gtetil/sap-system/sap-pcb/Sap Schematic.pdf

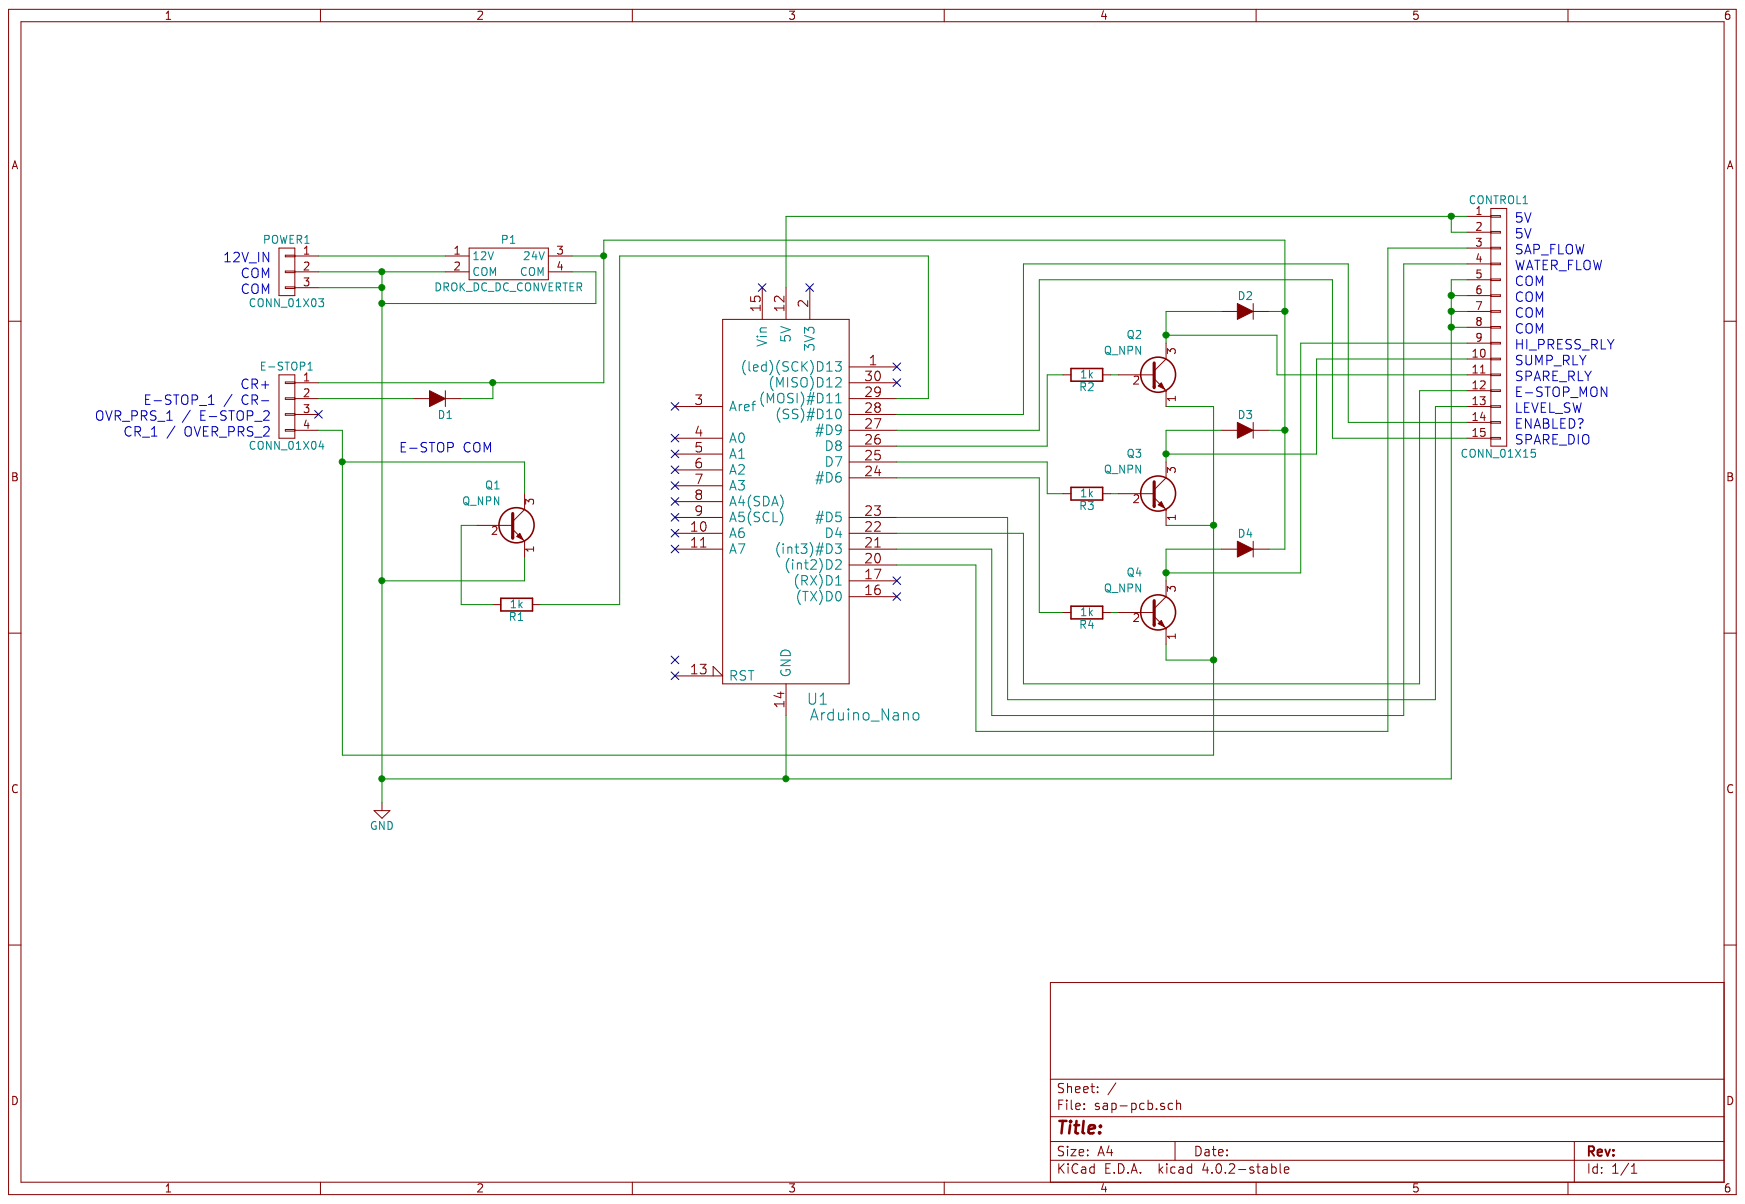
[picture p1: page 1]
