gtetil/sap-system/sap-pcb/sap-pcb.kicad_pcb

## KiCad design sap-pcb/sap-pcb.kicad_pcb (2017-02-03)

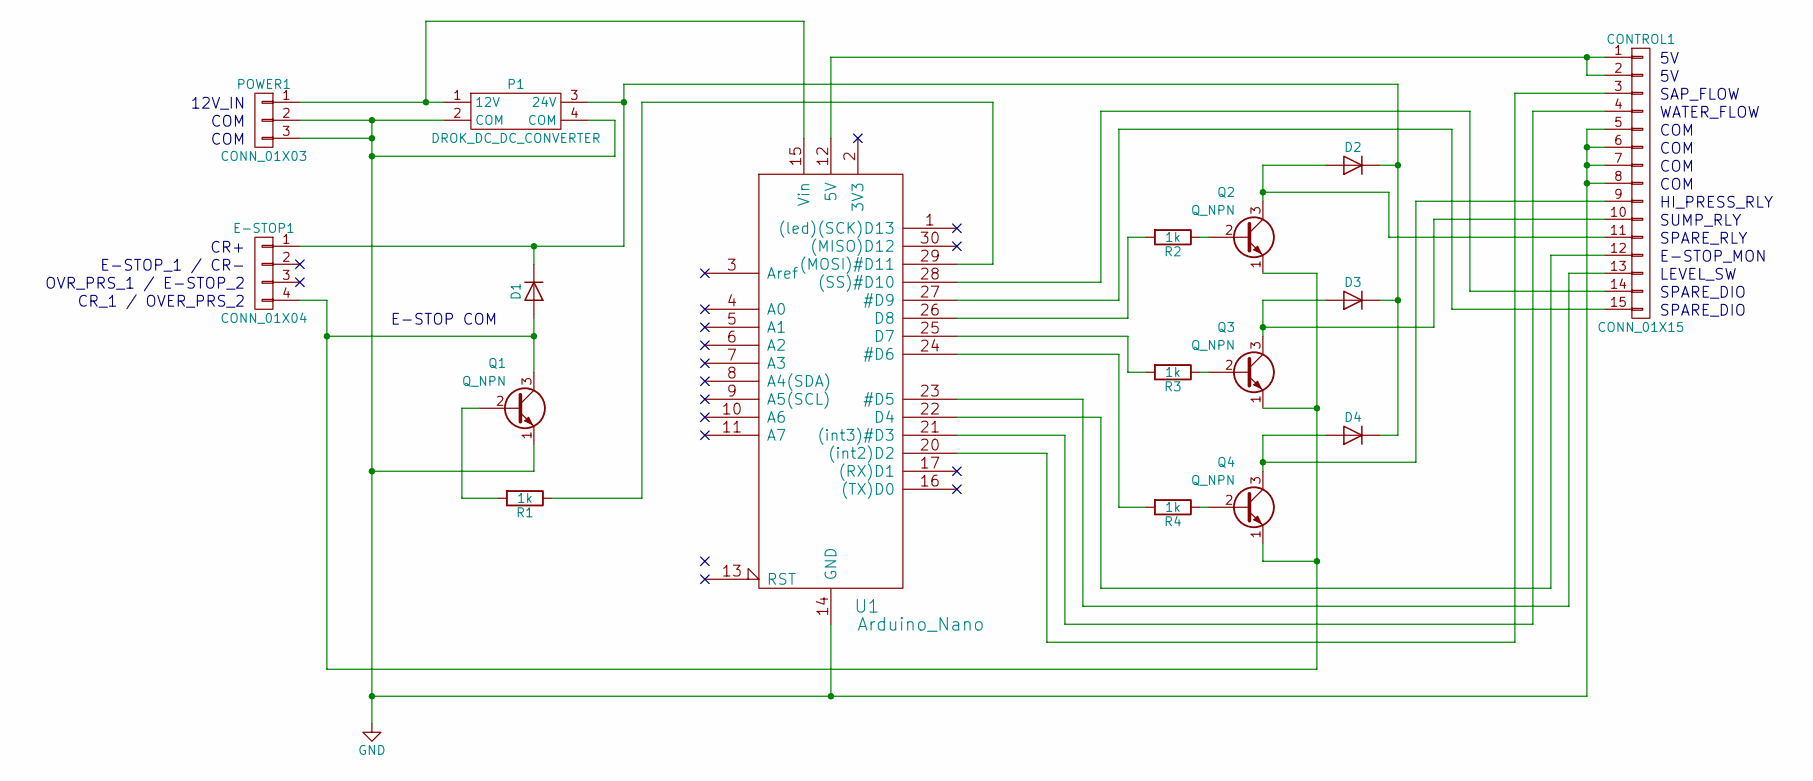
[picture p2: schematic sap-pcb.sch]

Parts:
CONTROL1: CONN_01X15; 15-PIN_CONN
D1, D2, D3, D4: D; D_A-405_P10.16mm_Horizontal
E-STOP1: CONN_01X04; 4-PIN_CONN
P1: DROK_DC_DC_CONVERTER
POWER1: CONN_01X03; 3-PIN_CONN
Q1, Q2, Q3, Q4: Q_NPN; TRANSISTOR
R1, R2, R3, R4: 1k; R_Axial_DIN0207_L6.3mm_D2.5mm_P10.16mm_Horizontal
U1: Arduino_Nano; ARDUINO_NANO

Connections:
GND: CONTROL1.5, CONTROL1.6, CONTROL1.7, CONTROL1.8, P1.2 (COM), P1.4 (COM), POWER1.2, POWER1.3, Q1.1 (E), U1.14 (GND), U1.19 (GND)
unnamed: CONTROL1.1, CONTROL1.2, U1.12 (5V)
unnamed: CONTROL1.3, U1.20 ((int2)D2)
unnamed: CONTROL1.4, U1.21 ((int3)#D3)
unnamed: CONTROL1.9, D4.2 (A), Q4.3 (C)
unnamed: CONTROL1.10, D3.2 (A), Q3.3 (C)
unnamed: CONTROL1.11, D2.2 (A), Q2.3 (C)
unnamed: CONTROL1.12, U1.22 (D4)
unnamed: CONTROL1.13, U1.23 (#D5)
unnamed: CONTROL1.14, U1.28 ((SS)#D10)
unnamed: CONTROL1.15, U1.27 (#D9)
unnamed: D1.1 (K), D2.1 (K), D3.1 (K), D4.1 (K), E-STOP1.1, P1.3 (24V)
unnamed: D1.2 (A), E-STOP1.4, Q1.3 (C), Q2.1 (E), Q3.1 (E), Q4.1 (E)
unnamed: P1.1 (12V), POWER1.1, U1.15 (Vin)
unnamed: Q1.2 (B), R1.2
unnamed: Q2.2 (B), R2.1
unnamed: Q3.2 (B), R3.1
unnamed: Q4.2 (B), R4.1
unnamed: R1.1, U1.29 ((MOSI)#D11)
unnamed: R2.2, U1.26 (D8)
unnamed: R3.2, U1.25 (D7)
unnamed: R4.2, U1.24 (#D6)

Notes on the sheet:
12V_IN
COM
E-STOP_1 / CR-
OVR_PRS_1 / E-STOP_2
CR+
CR_1 / OVER_PRS_2
SAP_FLOW
WATER_FLOW
HI_PRESS_RLY
SUMP_RLY
SPARE_RLY
E-STOP_MON
LEVEL_SW
SPARE_DIO
E-STOP COM

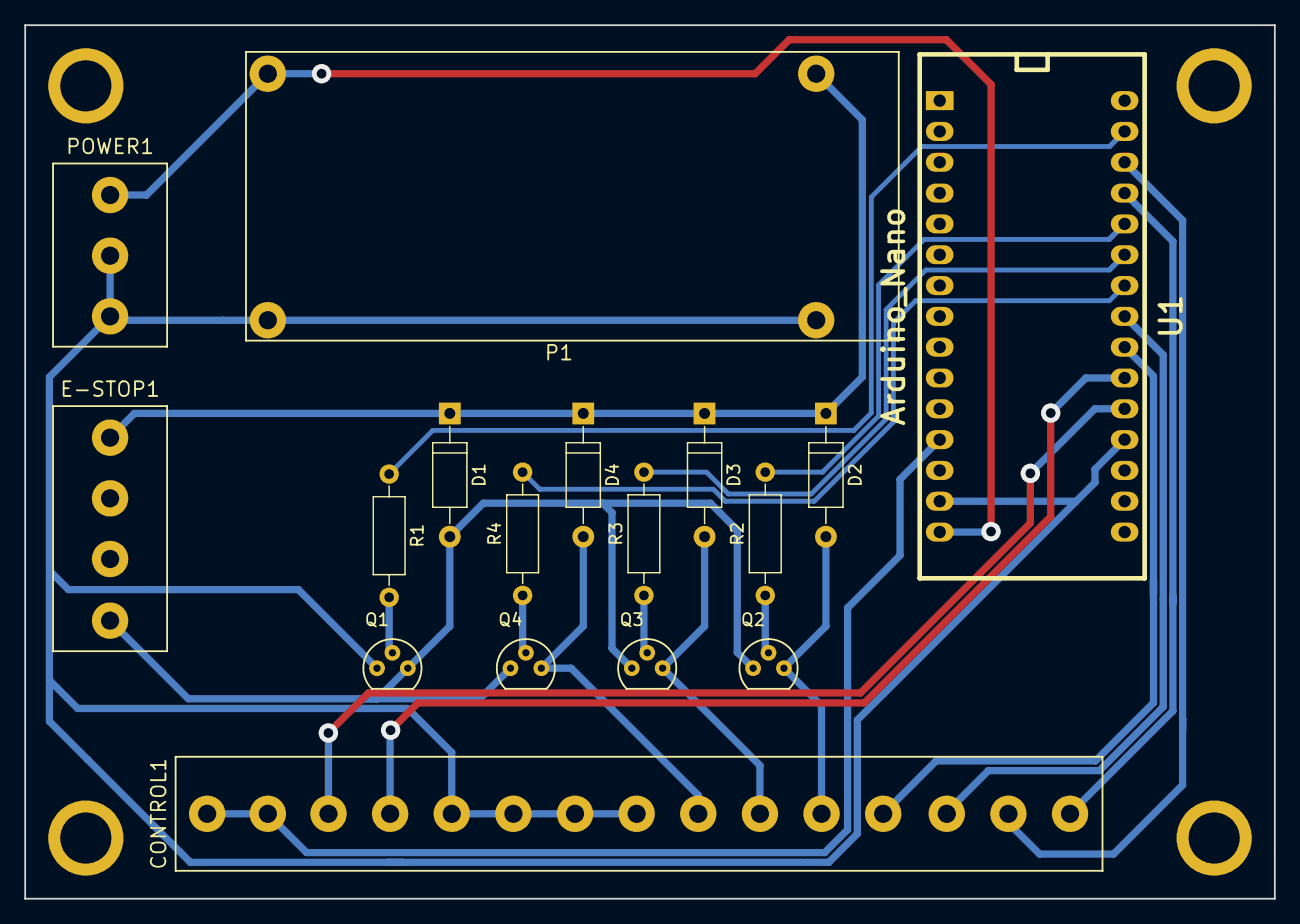
[picture p3: board sap-pcb.kicad_pcb from above]

Board: 2 copper layers, 103.0 x 72.0 mm, 17 parts (0 on the bottom side), 22 nets.
