gtetil/sap-system/sap_arduino/sap_arduino.ino

//flow meter pins (interrupts)
const byte sap_flow_pin = 2;
const byte water_flow_pin = 3;

//digital output pins
int hi_press_rly_pin = 6;
int sump_rly_pin = 7;
int spare_rly_pin = 8;
int enable_pin = 11;

//digital input pins
int estop_mon_pin = 4;
int level_sw_pin = 5;
int enabled_mon_pin = 10;

//digital output states
int hi_press_rly = 0;
int sump_rly = 0;
int spare_rly = 0;

//digital input states
int estop_mon = 0;
int level_sw = 0;
int enabled_mon = 0;

//config
int level_sw_mode = 0;
int min_flow = 3;
int hp_pump_on_delay = 5;

//sap flow variables

double sap_flow;
volatile unsigned long sap_count; //This integer needs to be set as volatile to ensure it updates correctly during the interrupt process.
unsigned long sap_prev_count;

unsigned long sap_delta_count;
double sap_k_factor;
double sap_cnts_per_gal = 3800;
double sap_gallons;

//water flow variables
double water_flow;
volatile unsigned long water_count; //This integer needs to be set as volatile to ensure it updates correctly during the interrupt process.
unsigned long water_prev_count;
unsigned long water_delta_count;
double water_k_factor;
double water_cnts_per_gal = 3800;
double water_gallons;

//total flow
double total_flow;
double total_gallons;
double efficiency;
double efficiency_total;

//auto mode
int run_auto;
int hp_pump_event;
int low_flow_flag;
int low_level_flag;

//delay auto mod
int delay_auto;
int prev_delay_auto;
double delay_hours;
double delay_hours_latched;
double countdown;
unsigned long delay_start_time = millis();
double elapsed_delay;

//misc
String data_string;
int system_status;
unsigned long main_timer = millis();
unsigned long flow_timer = millis();
unsigned long low_flow_timer = millis();
unsigned long hp_timer = millis();
int hp_delay_trigger;

void setup() {
  //serial setup
  Serial.begin(115200);
  
  //setup flow meter interrupts
  pinMode(sap_flow_pin, INPUT_PULLUP);
  attachInterrupt(digitalPinToInterrupt(sap_flow_pin), sapFlow, RISING);
  pinMode(water_flow_pin, INPUT_PULLUP);
  attachInterrupt(digitalPinToInterrupt(water_flow_pin), waterFlow, RISING);  
  
  //setup digital outputs and inputs
  pinMode(hi_press_rly_pin, OUTPUT);   //HI_PRESS_RLY
  pinMode(sump_rly_pin, OUTPUT);   //SUMP_RLY
  pinMode(spare_rly_pin, OUTPUT);   //SPARE_RLY
  pinMode(enable_pin, OUTPUT);   //ENABLE
  pinMode(estop_mon_pin, INPUT_PULLUP);  //E-STOP_MON
  pinMode(level_sw_pin, INPUT_PULLUP);  //LEVEL_SW
  pinMode(enabled_mon_pin, INPUT_PULLUP);  //ENABLED?

}

void loop() {

  if ((millis() - main_timer) >= 100) {
    main_timer = millis();
    digitalInputs();
    sendData();
  }

  if (total_flow > min_flow) {
    low_flow_timer = millis();
  }

  if ((millis() - flow_timer) >= 1000) {  //timed loop for flow calculations
    flow_timer = millis();
    calcSapFlow();
    calcWaterFlow();
    calcTotalFlow();
  }

  checkSerial();
  
  if ((hp_delay_trigger ==1) && (millis() - hp_timer) >= (hp_pump_on_delay * 1000)) {
    hp_delay_trigger = 0;
    digitalOutput("hi_press_rly", 1);
    low_flow_timer = millis();
  }
  
  if (enabled_mon == 0) {  //if estop circuit opens, turn off all digital outputs
    eStop();
  }

  if ((run_auto == 1) && (hi_press_rly == 1) && (millis() - low_flow_timer) > 3000) {  //eStop if flow loss during auto mode
    eStop();
    low_flow_flag = 1;  //used for pop-up on HMI
  }

  if ((run_auto == 1) && (level_sw_mode == 1) && (level_sw == 0)) {  //eStop if low level during auto mode and level sw mode
    eStop();
    low_level_flag = 1;  //used for pop-up on HMI
  }

  if (delay_auto == 1) {
    if (prev_delay_auto == 0) {
      delay_hours_latched = delay_hours;
      delay_start_time = millis();
    }
    elapsed_delay = millis() - delay_start_time;
    countdown = delay_hours_latched - (elapsed_delay / 3600000);
    if (countdown <= 0) {
      countdown = 0;
      delay_auto = 0;
      run_auto = 1;
      runAuto();
    }
  }
  prev_delay_auto = delay_auto;
  
  
  //update system status
  if (run_auto == 1) {
    system_status = 2; //"Auto_Run"
  }
  else if (delay_auto == 1) {
    system_status = 4; //"Delayed Auto"
  }
  else if (enabled_mon == 1) {
    system_status = 1; //"Enabled"
  }
  else {
    system_status = 0; //"Off"
  }
  
}

void sendData() {
  data_string = "";
  addStringData(String(hi_press_rly));
  addStringData(String(sump_rly));
  addStringData(String(spare_rly));
  addStringData(String(estop_mon));
  addStringData(String(level_sw));
  addStringData(String(enabled_mon));
  addStringData(String(sap_flow));
  addStringData(String(water_flow));
  addStringData(String(total_flow));
  addStringData(String(sap_count));
  addStringData(String(water_count));
  addStringData(String(sap_gallons, 1));
  addStringData(String(water_gallons, 1));
  addStringData(String(total_gallons, 1));
  String eff_string = String(efficiency);
  if (eff_string == " NAN") {
    eff_string = "0";
  }
  addStringData(eff_string);
  String eff_tot_string = String(efficiency_total);
  if (eff_tot_string == " NAN") {
    eff_tot_string = "0";
  }
  addStringData(eff_tot_string);
  addStringData(String(low_flow_flag));
  addStringData(String(low_level_flag)); 
  addStringData(String(system_status));
  addStringData(String(sap_cnts_per_gal));
  addStringData(String(water_cnts_per_gal));
  addStringData(String(countdown, 3));
  Serial.println(data_string);
}

void addStringData(String data) {
  data_string += data + ",";
}

void calcTotalFlow() {
  total_flow = sap_flow + water_flow;
  total_gallons = sap_gallons + water_gallons;
  efficiency = (sap_flow / total_flow) * 100;
  efficiency_total = (sap_gallons / total_gallons) * 100;
}

void calcSapFlow() {
  sap_delta_count = sap_count - sap_prev_count;
  sap_prev_count = sap_count;
  sap_gallons = sap_count / sap_cnts_per_gal;
  sap_k_factor = 3600 / sap_cnts_per_gal; //7200 @ 500ms
  sap_flow = sap_delta_count * sap_k_factor;
}

void calcWaterFlow() {
  water_delta_count = water_count - water_prev_count;
  water_prev_count = water_count;
  water_gallons = water_count / water_cnts_per_gal;
  water_k_factor = 3600 / water_cnts_per_gal; //7200 @ 500ms
  water_flow = water_delta_count * water_k_factor;
}

void digitalInputs() {
  estop_mon = !digitalRead(estop_mon_pin);
  level_sw = !digitalRead(level_sw_pin);
  enabled_mon = !digitalRead(enabled_mon_pin);
}

void checkSerial() {
  while (Serial.available() > 0) {
    String command = Serial.readStringUntil('/');
    
    if (command == "digital_output") {
      String tag = Serial.readStringUntil('/');
      int state = Serial.parseInt();
      digitalOutput(tag, state);
    }
    else if (command == "app_config") {
      String tag = Serial.readStringUntil('/');
      int state = Serial.parseInt();
      appConfig(tag, state);
    }
    else if (command == "flow_config") {
      String tag = Serial.readStringUntil('/');
      double value = Serial.parseFloat();
      flowConfig(tag, value);
    }
    else if (command == "run_auto") {
      run_auto = Serial.parseInt();
      if (run_auto == 0) {
        eStop();  //if auto mode is turned off, turn off all outputs
      }
      else {
        runAuto();
      }
    }
    else if (command == "delay_auto") {
      if (run_auto == 0) {
        delay_auto = Serial.parseInt();
      }
    }
  }
}

void runAuto() {
  low_flow_flag = 0; //reset flags in case they tripped during previous auto run
  low_level_flag = 0;
  digitalOutput("sump_rly", 1);
  hp_delay_trigger = 1;  //turn on high pressure pump after delay
  hp_timer = millis();
}

void flowConfig(String tag, double value) {
  if (tag == "sap_cnts_per_gal") {
    sap_cnts_per_gal = value;
  }
  else if (tag == "water_cnts_per_gal") {
    water_cnts_per_gal = value;
  }
  else if (tag == "reset_sap") {
    sap_count = value;
  }
  else if (tag == "reset_water") {
    water_count = value;
  }
  else if (tag == "delay_hours") {
    delay_hours = value;
  }
}  

void appConfig(String tag, int state) {
  if (tag == "level_sw_mode") {
    level_sw_mode = state;
  }
  else if (tag == "min_flow") {
    min_flow = state;
  }
  else if (tag == "hp_pump_on_delay") {
    hp_pump_on_delay = state;
  }
}

void digitalOutput(String tag, int state) {
  if (tag == "hi_press_rly") {
    if (sump_rly == 0) {
      state = 0;  //if sump pump is off, never turn on high pressure pump
    }
    hi_press_rly = state;
    digitalWrite(hi_press_rly_pin, state);
  }
  else if (tag == "sump_rly") {
    sump_rly = state;
    digitalWrite(sump_rly_pin, state);
    if (state == 0) {
      digitalWrite(hi_press_rly_pin, 0); //turn of high pressure pump if sump is turned off
      hi_press_rly = 0;
    }
  }
  else if (tag == "spare_rly") {
    spare_rly = state;
    digitalWrite(spare_rly_pin, state);
  }
  else if (tag == "enable") { //this is a momentary switch to seal estop circuit
    digitalWrite(enable_pin, 1);
    delay(100);
    digitalWrite(enable_pin, 0);
  }
}

void eStop() {
  hp_delay_trigger = 0;
  digitalOutput("hi_press_rly", 0);
  digitalOutput("sump_rly", 0);
  digitalOutput("spare_rly", 0);
  run_auto = 0;
  delay_auto = 0;
}

void sapFlow() {
   sap_count++; //Every time this function is called, increment "count" by 1
}

void waterFlow() {
   water_count++; //Every time this function is called, increment "count" by 1
}
