gtetil/sap-system/sap-kivy/flowCluster.py

from kivy.uix.slider import Slider
from kivy.uix.boxlayout import BoxLayout
from kivy.properties import NumericProperty, StringProperty, ObjectProperty
from kivy.uix.label import Label
from kivy.factory import Factory
from kivy.lang import Builder

Builder.load_string("""
<FlowCluster>:
    orientation: 'vertical'
    label: self.label
    flow: self.flow
    gallons: self.gallons

    Label:
        text: root.label
        font_size: '40sp'
        markup: 'True'

    Label:
        text: root.flow + '[size=20]  GPH[/size]'
        font_size: '45sp'
        markup: 'True'

    Label:
        text: root.gallons + '[size=20]  gal[/size]'
        font_size: '30sp'
        markup: 'True'

""")

class FlowCluster(BoxLayout):
    label = StringProperty('')
    flow = StringProperty('')
    gallons = StringProperty('')

Factory.register('KivyB', module='FlowCluster')
