gtetil/sap-system/(commit log)

2017-01-29 copied kivy files form dashIO.
    [sap-pcb.kicad_pcb, sap-pcb.sch]
2017-01-30 finished circuit design. still need to give look over.
    [sap-pcb.sch]
2017-02-01 finished kicad components.
    [sap-pcb.kicad_pcb, sap-pcb.sch]
2017-02-01 almost completed pcb design.
    [sap-pcb.kicad_pcb]
2017-02-02 finished pcb design.
    [sap-pcb.kicad_pcb]
2017-02-03 created gerbers, circuitCAM, and LMD file.
    [sap-pcb.kicad_pcb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]
2017-02-07 started adding digital write code to arduino.
2017-02-07 renamed folders, and added kivy code (copied from smart-tank-kivy).
    [sap-pcb.kicad_pcb, sap-pcb.sch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]
2017-02-08 nearly completed arduino code. auto_run still needs work.
2017-02-09 finished arduino code, but not debugged.
2017-02-10 created flowCluster.
2017-02-28 changed flow variables in arduino to unsigned long instead of int. there was an issue with overflow and gallons going negative.
    added Efficiency (Total) to kivy.
    [main.py, sap_arduino.ino]
2018-02-26 - Added some variables to Arduino to read back sap and water counts per gallon. - Separated sap and water cal buttons and added diagnostics to screen for counts and counts per gallon. - Fixed bug whe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
    [main.py, sap_arduino.ino]
2025-03-18 Finished new flowmeter installation.
